lorenzogalli-dev/Prostart/Papers/Final Paper/CM2024_Sprint_Start_Final_Paper.pdf

## Prostart: Democratizing Sprint Training with a Low-Cost Reaction-Time and Photo-Finish System for Track & Field

Arianna Bartocci, Duarte Chambel, Lorenzo Galli, Loke Enlund Östangård, Ninad Purekar
KTH Royal Institute of Technology

Technology and Health Project Course - HT26

Abstract
Sprint races are decided by milliseconds, yet the systems that time reaction and finish are costly [1] and stay with federations and large clubs, while everyone else times by hand. We present Prostart: a start unit that mounts onto a standard starting block, and a phone app that turns a smartphone into a photo finish. The unit, an ESP32-C3 with a BMI270 accelerometer sampled at 804 Hz on a custom PCB in a 3D-printed box, gives the start commands, finds the push-off with a threshold-independent twostage onset picker, and sends the “go” instant over Bluetooth Low Energy (BLE) to the phone, which times the chest crossing the line with an on-device pose model, a synchronized clock and sub-frame interpolation. Against 240 fps video with an LED marking “go”, reaction times agreed within about 8 ms, the uncertainty of the video reference itself; finish times agreed with a 60 fps reference within 10 ms, a third of our one-frame target (33 ms at 30 fps), whereas hand timing read about 0.24 s fast.

### 1 Introduction

In competitive sprinting, athletes train for years to
gain a few hundredths of a second: Noah Lyles won
the Paris 2024 Olympic 100 m final by five thousandths [2]. Reaction times differ by several hundredths between elite sprinters [3], so part of the winning margin is decided before the athlete has even moved. Reaction time runs from the starting signal to the first force on the block; under 0.100 s is a false start, a limit based on the minimum auditory reaction time [4], and the fastest valid Olympic reactions lie just above it [3, 5]. The systems that measure it are installed at certified meets [6], and even a single-block training version lists at about US$1,600 [1]. Coaches therefore time by hand, which reads about 0.24 s faster than electronic timing [7]: an error larger than the gains an athlete trains for. Photocells start when the torso breaks a beam, so their times exclude the reaction [8]. FinishLynx ReacTime measures reaction to 1/1000 s from a sensor on every block [6]; its patent detects the onset when acceleration crosses a threshold [9], which by construction reports it late. Omega samples the force on the footrest at 4 kHz and pairs it with a finish camera of up to 40,000 images per second [10], and earlier student work used load cells, robust in 18 of 20 starts but without a timing-accuracy characterization [11]. All of these are either costly or built into the block, leaving a gap for a low-cost, portable system with a documented error budget.
This paper contributes (i) a start unit on one microcontroller, from schematic to PCB to printed enclosure, whose onset picker is independent of its threshold; (ii) a Flutter app that mirrors the start and turns the phone camera into a photo finish, synchronized to the unit over BLE; and (iii) a validation of both against high-speed video, with every error term named. The unit started as a breadboard prototype (Appendix B) and is now a complete system: the unit in its printed box and the app (Figure 1).


Figure 1. The complete system: the start unit in its printed box on the block (left) and the app (right).

### 2 System design

Architecture. The system has two devices joined by one radio link (Figure 2). The start unit sounds the commands, stamps them and the push-off on its own clock, and decides the verdict. The phone, standing at the finish, mirrors the start and times the finish. The microcontroller at the start reads the accelerometer and runs the radio. Each reading is timestamped in an interrupt and buffered in the sensor’s FIFO, so Bluetooth traffic can delay it but never silently shift or lose a reading. A direct BLE link covers about 30 m, enough for start and acceleration work; for a full 100 m we plan a second ESP32-C3 at the finish, linked to the start unit over long-range ESP-NOW, which we field-tested beyond 100 m, and to the phone over BLE.

BMI270
804 Hz, ±16 g

ESP32-C3
ISR stamps 1 µs

piezo
4 kHz

TFT +
button

FIFO

start unit (on the block)

camera
240 fps, 1/1000 s

MediaPipe Pose
chest front

crossing, interp.
tfin − tgo

phone app (at the finish)

events
marks, set, go,
result

BLE ping/pong
clock sync
Figure 2. System overview. The start unit judges the start; the phone gets the “go” on its clock and times the finish.

Prostart: Democratizing Sprint Training with a Low-Cost Reaction-Time and Photo-Finish System for Track & Field | 2

Hardware. A two-layer PCB (65.5×34 mm, Appendix B) carries an ESP32-C3 SuperMini, a BMI270
accelerometer breakout on I²C at 400 kHz with its data-ready line on an interrupt pin, a 1.77” display on SPI, a push button, and a 12 mm passive piezo. The unit runs from a USB power bank through the SuperMini’s USB-C port. The enclosure, 75×99.5×25 mm, was designed around the board and printed in three parts (Figure 3, left): a box with standoffs for the PCB, a lid with cutouts for the display and for the buzzer, and a button cap. Lastly a standard strap holds the box to the block’s rail. Figure 3 (right) shows the assembled board mounted on the standoffs inside the printed box.

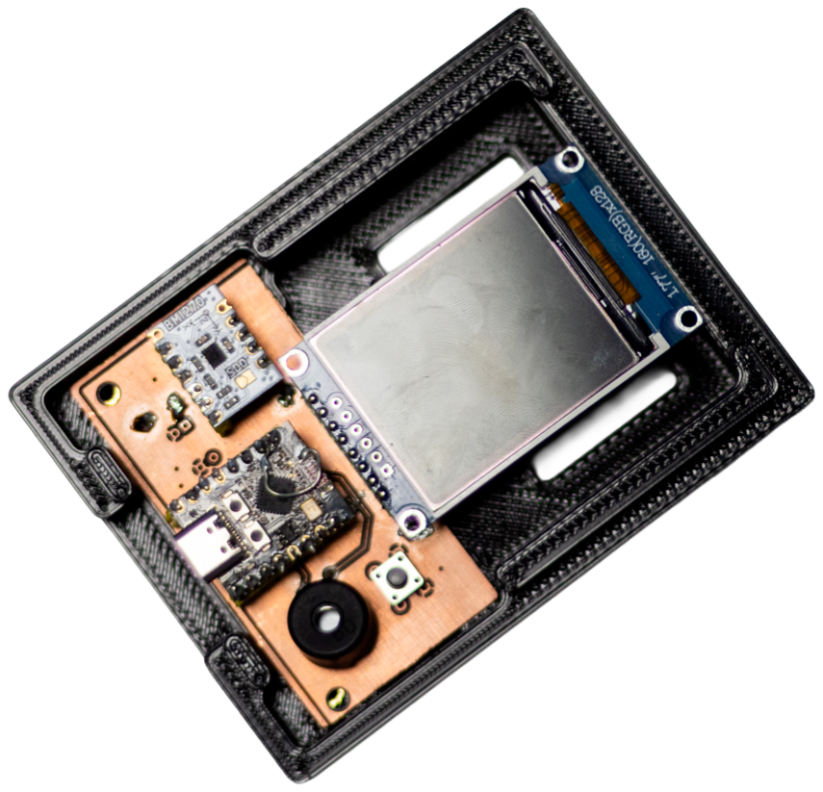
[picture p15: figure]

Figure 3. The enclosure: exploded render of the three printed parts from their STL files (left) and the assembled PCB inside the printed box (right).

Start sequence. A press starts a 3 s countdown, then “on your marks”; “set” follows 20–25 s later. The unit then waits until the sprinter is measured still (horizontal acceleration under 15 mg for 200 ms) and fires “go” a random 0.7–1.5 s later, which makes “go” hard to anticipate. Each beep is a 4 kHz, 100 ms tone and introduces no software latency into the reaction time.
Onset detection. The BMI270 runs at 800 Hz nominal (803.6 Hz measured), ±16 g. Gravity is estimated at rest as a vector, so every sample splits into vertical and horizontal parts whatever the mounting angle. An STA/LTA trigger [12] (15/800 ms windows, ratio 6, 20 mg floor) decides that the athlete moved; Maeda’s AIC picker [13] then finds, from 150 ms before to 50 ms after the trigger, the sample that best splits a quiet segment from an active one, and reports it as the onset. Because this second step has no threshold, the onset does not move with the trigger level: across 79 starts and thresholds of 10–50 mg it stayed on the same sample in 70 starts and within one in 74, while a threshold-only detector drifted by a median 9.3 ms (Appendix D). After the result, the unit sends the run to the app over BLE, which saves it as CSV; the board keeps it in RAM until the app confirms.
App and clock synchronization. The Flutter app (iOS) connects to the unit’s GATT service. In Reaction mode it mirrors the unit’s phases and shows the reaction time. In Photofinish mode it also times the finish and reports total, reaction and run time (Figure 4); for this, the board’s “go” instant must be converted to the phone’s clock, so the app estimates the offset θ (phone time minus board time). Between “on your marks” and “set” the phone pings the board for 10 s. Each ping has four timestamps: the phone sends at t1, the board receives at t2 and replies at t3, and the phone receives at t4. Each one-way difference equals ±θ plus a transmission delay that varies but is never negative, so the smallest value in each direction is the least noisy:
a = min(t2 − t1), | b = min(t4 − t3), | θ =
b−a
2
The two directions are minimized separately because BLE delays are asymmetric: a reply waits for the next connection event, which can skew a single round trip by up to one interval (15–30 ms on iOS) [14]. The offset error is bounded by half the minimum round trip, (a+b)/2, which the app computes on every sync. On an iPhone 13 this bound was 19 ms, set by the ∼30 ms iOS connection interval (forcing 15 ms had no effect). The bound is conservative, as it assumes the entire minimum delay falls in one direction; the end-to-end photofinish comparison (Sec. 3) suggests the actual error is considerably smaller. Clock drift (20–50 ppm) adds under 0.5 ms between sync and start.


Figure 4. The app’s result screen after a 10 m run on an iPhone 13.

Camera-based photo finish. The phone stands in line with the finish, and the user drags a line onto the real one. The camera runs at its highest frame rate (240 fps on an iPhone 13), with no stabilization and a short exposure (1/1000 s) against motion blur; every frame keeps the time it was captured, on the same clock the synchronization uses. From “go” the frames are kept in memory, and when a body enters a narrow band around the line, MediaPipe Pose [15] analyzes the pass. The rules time the torso [16], but the pose landmarks are joints inside the body, so the center of the torso crosses about 20 ms after the chest. We therefore take the chest front from the body silhouette: between shoulders and hips, with the arm removed, the frontmost edge of each row, and the 80th percentile of these edges, so a stray forearm cannot move it. Between the last frame before the line and the first after it, interpolation gives the crossing instant, and a line fit over ±160 ms

Prostart: Democratizing Sprint Training with a Low-Cost Reaction-Time and Photo-Finish System for Track & Field | 3

smooths per-frame noise. The time is shown to the
millisecond and, as the rules prescribe, rounded up
to the hundredth [16]. The detector was first written in Python and then ported to the app; on the same clips the two agree within a few ms (0.864 vs. 0.862 s at 240 fps).

### 3 Evaluation & Results

Timing path. On the PCB the unit samples at 803.6 Hz with no gaps and no dropped samples, a maximum interval of 1.25 ms, and 0.55 µs timestamp jitter. Re-running the detector offline on every capture gives the board’s onset on the same sample (e.g. 163.8 ms). The unit’s own resolution is therefore one sample, 1.2 ms. Figure 5 shows what the detector sees in a block start.


Figure 5. A block start recorded with the first prototype: raw acceleration, horizontal magnitude and STA/LTA ratio after “go” (green), with the AIC onset (black) at 138 ms, 16.2 ms before the threshold-only onset (dotted).

Reaction time vs. 240 fps video. As an independent reference, we filmed the block at 240 fps (4.2 ms per frame) during test starts and took the reaction time from the footage as the interval between the “go” signal and the push-off. The “go” instant is the first frame in which the green LED is lit. The push-off is harder to place: the shoe starts to compress against the block before the athlete visibly moves, so the frame was chosen by eye and may be off by a frame or two. Figure 6 shows the two video frames for an example start and the board’s reading.

Figure 6. Example start: the “go” frame with the green LED lit (left), the push-off frame at 240 fps (middle), and the reaction time shown by the prototype (right).
Board and video agreed within about 8 ms, roughly two frames. The buzzer was about 1.5 m from the athlete, so the sound arrives about 4.4 ms after “go” (at 343 m/s). This is a systematic offset, and for a known distance it can be subtracted. The board’s error is therefore at most about 8 ms, a bound set by the video reference itself; with a sharper reference, we expect it to approach the 1.24 ms sampling interval of the accelerometer. Photo finish. The finish time depends on the clock synchronization between the unit and the phone, the camera frame timestamps and the crossing detector, so we validated them together, end to end. In a test run against a 60 fps reference video read frame by frame, the app’s finish time differed by 10 ms. This is less than one frame of the reference video (16.7 ms) and well within the 33 ms (one frame at 30 fps) target set at the design stage. As with the reaction time, the reference cannot resolve differences much below one frame, while the app interpolates between the frames surrounding the line to obtain a sub-frame crossing time (Figure 7); more runs are needed to characterize its error. We also timed the same run by hand: the stopwatch read about 0.2– 0.3 s faster than the app, in line with the 0.24 s reported in the literature [7].


Figure 7. The app’s result frame at the crossing: finish line, body silhouette (cyan) and the timed chest point.

Limitations. The validation is preliminary: the finish time rests on a single run, and both video references bound the error rather than measure it; a finer validation is planned. Besides the constant delays, the direct BLE link reaches about 30 m, so a full 100 m needs the relay planned in Section 2. In low light the exposure cannot go below about 1/250 s, increasing motion blur. An arm across the chest can hide the chest edge, and with two athletes in frame the detector times the larger torso, so the app is meant for one athlete per run.

### 4 Conclusions

We built a start unit on one microcontroller, from PCB to printed box, and a phone app that together time a sprinter’s reaction and finish, for about 300 SEK in parts (Table 2), against about US$1,600 for a single-block commercial trainer [1]. Against video, reaction times agreed within about 8 ms, the uncertainty of the reference itself, and a first finish time within 10 ms, whereas a stopwatch read about 0.24 s fast. Next, a 1000 fps camera will check the unit’s 1.24 ms sampling interval directly and measure the constant delays of the sensor and the sound, and the unit, now powered by a USB power bank, will move to a built-in LiPo cell.

Prostart: Democratizing Sprint Training with a Low-Cost Reaction-Time and Photo-Finish System for Track & Field | 4

### References

[1] VS Athletics. ReacTime Personal Training System (SKU Z5110), Lynx. https://www.vsathletics.com/store/ReacTime-Personal-Training-System.html, (https://www.vsathletics.com/store/ReacTime-Personal-Training-System.html) accessed 21 Sept 2026.
[2] Olympics.com. Paris 2024 athletics: Noah Lyles wins Olympic men’s 100m gold in a photo finish, 2024. https: //www.olympics.com/en/news/noah-lyles-wins-paris-2024-athletics-olympic-mens-100m-gold, accessed 19 Sept 2026.
[3] D. B. Lipps, A. T. Galecki, and J. A. Ashton-Miller. On the implications of a sex difference in the reaction times of sprinters at the Beijing Olympics. PLoS ONE, 6(10):e26141, 2011. doi:10.1371/journal.pone.0026141.
[4] M. T. G. Pain and A. Hibbs. Sprint starts and the minimum auditory reaction time. Journal of Sports Sciences, 25(1):79–86, 2007. doi:10.1080/02640410600718004.
[5] K. C. Brosnan, K. Hayes, and A. J. Harrison. Effects of false-start disqualification rules on response-times of elitestandard sprinters. Journal of Sports Sciences, 35(10):929–935, 2017. doi:10.1080/02640414.2016.1201213.
[6] FinishLynx. | ReacTime false start detection system. | https://www.finishlynx.com/product/
reactime-false-start-detection/, (https://www.finishlynx.com/product/reactime-false-start-detection/) accessed 21 Sept 2026.
[7] J. B. Mann, P. J. Ivey, W. F. Brechue, and J. L. Mayhew. Validity and reliability of hand and electronic timing for 40-yd sprint in college football players. Journal of Strength and Conditioning Research, 29(6):1509–1514, 2015. doi:10.1519/JSC.0000000000000941.
[8] T. A. Haugen, E. Tønnessen, and S. K. Seiler. The difference is in the start: impact of timing and start procedure on sprint running performance. Journal of Strength and Conditioning Research, 26(2):473–479, 2012. doi:10.1519/JSC.0b013e318226030b.
[9] E. Widding, D. DeAngelis, and A. Barton (Lynx System Developers, Inc.). Reaction time measurement system. US Patent 6,002,336, 1999. PCT publication WO 1999/032889 A2.
[10] OMEGA. Official Timekeeper: a legacy of Olympic precision since 1932. https://www.omegawatches.com/en-us/world-of-omega/olympic-and-paralympic-games/official-timekeeper, (https://www.omegawatches.com/en-us/world-of-omega/olympic-and-paralympic-games/official-timekeeper) accessed 21 Sept 2026.
[11] F. Heim, I. R. Kristinsson, A. Rosato, and M. Zimmermann. Design of a sprint block for force and reaction time measurement. Course paper, November 2020.
[12] R. V. Allen. Automatic earthquake recognition and timing from single traces. Bulletin of the Seismological Society of America, 68(5):1521–1532, 1978.
[13] N. Maeda. A method for reading and checking phase times in auto-processing system of seismic wave data. Zisin (Journal of the Seismological Society of Japan), 38(3):365–379, 1985.
[14] F. Cristian. | Probabilistic clock synchronization. | Distributed Computing, 3(3):146–158, 1989.
doi:10.1007/BF01784024.
[15] V. Bazarevsky, I. Grishchenko, K. Raveendran, T. Zhu, F. Zhang, and M. Grundmann. BlazePose: on-device real-time body pose tracking. CVPR Workshop on Computer Vision for Augmented and Virtual Reality, 2020. arXiv:2006.10204.
[16] World Athletics. Competition Rules, Book C2.1: Technical Rules, Rule 19 (Timing and Photo Finish). https://worldathletics.org/about-iaaf/documents/book-of-rules, accessed 18 Oct 2026.
[17] Bosch Sensortec. BMI270: 6-axis smart, low-power inertial measurement unit, datasheet. https://www.bosch-sensortec.com/products/motion-sensors/imus/bmi270/, accessed 18 Oct 2026.

Prostart: Democratizing Sprint Training with a Low-Cost Reaction-Time and Photo-Finish System for Track & Field | 5

### A Source code

Everything needed to rebuild the system is in one repository, https://github.com/lorenzogalli-dev/Prostart:

Folder | Content
Arduino/AlgorithmRealTimeESP32/ | start-unit firmware (ESP32-C3 + BMI270, BLE); wiring, build and test notes
Arduino/AlgorithmRealTime/ | first prototype (XIAO nRF52840 Sense), same detector
Arduino/EspNowLrTest/ | long-range ESP-NOW field test for the finish relay, with its measurements
prostart/ | Flutter app and its native camera plugin (photo finish)
AI_Torso_Detector/ | Python reference of the photo-finish detector (MediaPipe)
Hardware/ | KiCad project, Gerbers and BOM (PCB_ProStart_POC/); enclosure STL files
(Enclosure/)
Data/, Arduino/*/Data/ | recorded block starts (CSV), used for the threshold sweep (Appendix D)
Table 1. Repository layout.

### B Hardware

The first prototype (Figure 8) was a Seeed XIAO nRF52840 Sense, whose on-board LSM6DS3 accelerometer sampled at about 865 Hz, with a button and the buzzer on a breadboard; it recorded the 79 block starts of Appendix D and validated the detector. The final unit moves to an ESP32-C3 with an external BMI270, whose FIFO decouples sampling from the radio, on a custom two-layer PCB (Figures 9 and 10). Table 2 lists the parts, the pin map and their cost.

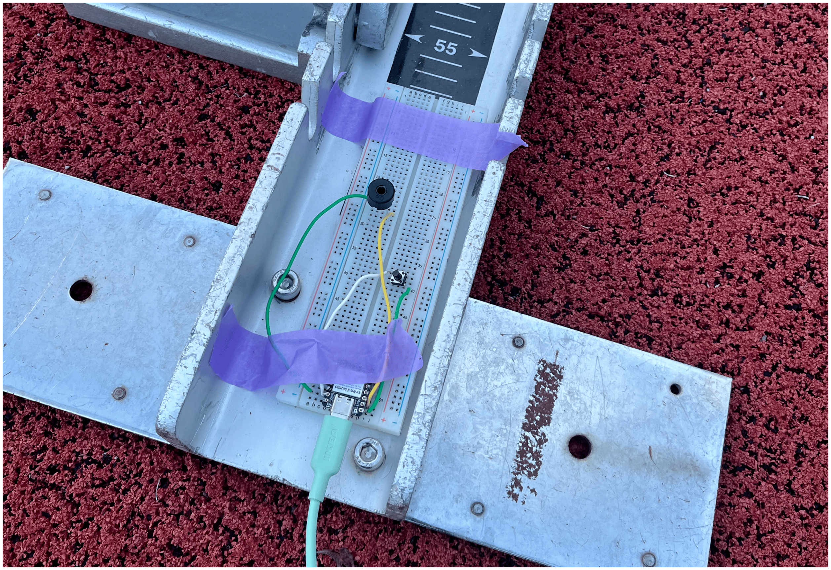
[picture p16: figure]
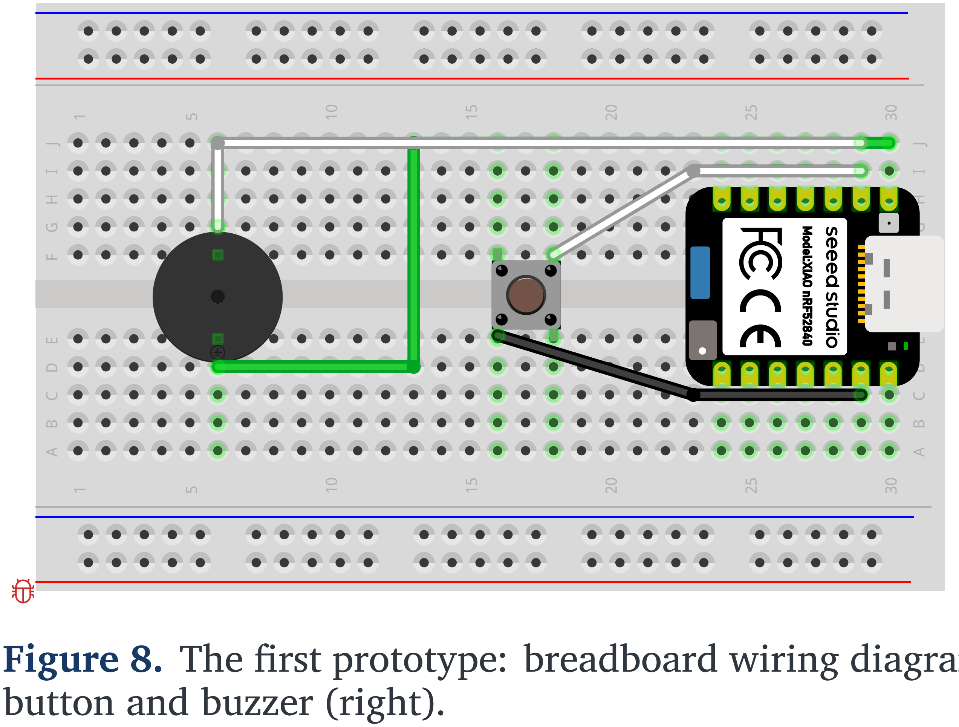
[picture p17: figure]
button and buzzer (right).

Figure 8. The first prototype: breadboard wiring diagram (left) and the real breadboard with the XIAO nRF52840 Sense,

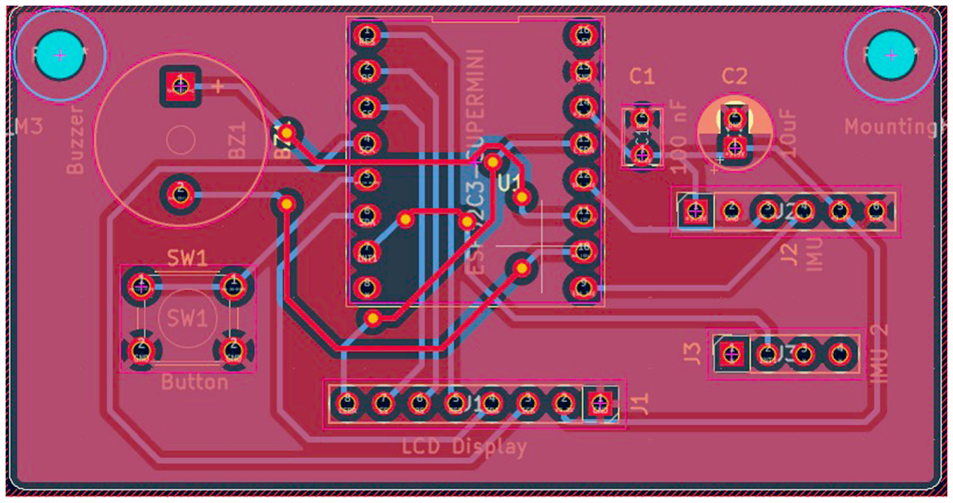
[picture p18: figure]

Figure 9. Schematic of the start unit (left) and routed layout of the 65.5×34 mm PCB (right). J2/J3: BMI270 breakout (I²C, INT1); J1: TFT display; BZ1: piezo between GPIO1 and GPIO2.

Prostart: Democratizing Sprint Training with a Low-Cost Reaction-Time and Photo-Finish System for Track & Field | 6

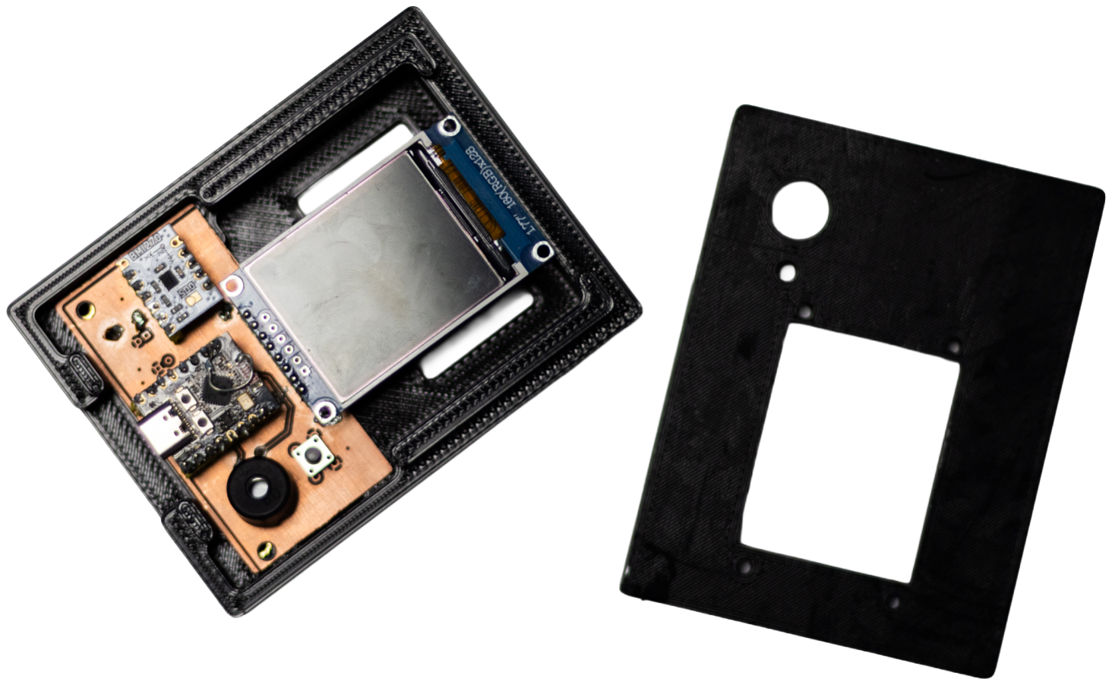
[picture p19: figure]
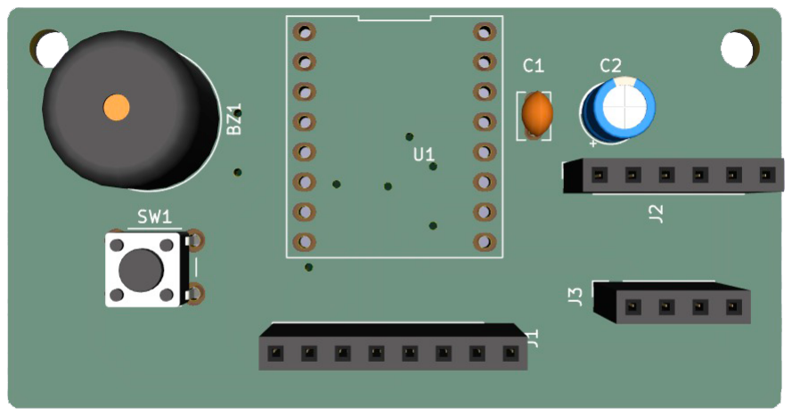
[picture p20: figure]

Figure 10. The final unit: 3D view of the PCB (left) and the assembled board with display in the printed box (right).

Ref. | Part | Connection | SEK*
U1 | ESP32-C3 SuperMini | – | 40
J2, J3 BMI270 breakout [17] | SDA GPIO0, SCL GPIO3, INT1 GPIO20 | 100
J1 | 1.77” ST7735 TFT, 128×160 | SCK 8, MOSI 10, CS 7, DC 6, RES 5, BL 4 | 70
SW1 | 6 mm push button | GPIO9 to GND | 5
BZ1 | 12 mm piezo buzzer | GPIO1 / GPIO2, antiphase | 10
C1, C2 100 nF, 10 µF | 3.3 V rail | 5
– | Two-layer PCB, 65.5×34 mm (batch of 5) – | 30
– | Printed box, lid and button cap (PLA) | – | 15
– | Strap | – | 20
| Total | | ≈295
Table 2. Bill of materials, pin map and estimated part prices. *Estimated one-off retail prices in October 2026, excluding the phone and the USB power bank that powers the unit. The green validation LED (GPIO21, Section 3) is not part of the product.

### C Firmware parameters and BLE protocol

Table 3 collects the constants of Section 2 in one place, while Table 4 is the GATT service the app talks to.

Parameter | Value
Sampling | BMI270, 800 Hz nominal (803.6 Hz measured), ±16 g, 0.488 mg/LSB; FIFO of 337 frames (0.42 s);
| data-ready stamped in the ISR (1 µs clock)
Sequence | countdown 3 s; marks → set 20–25 s; arm when <15 mg for 200 ms (at least 800 ms after set, at
| most 4 s); go 0.7–1.5 s after arming
Beep | 4 kHz, 100 ms, two register writes, stamped at the write
STA/LTA | 15 ms / 800 ms, on at ratio 6, off at 2, 20 mg floor, 15 ms confirmation
AIC window | 150 ms before, 50 ms after the trigger
False start | onset < 100 ms after go
Timing check before every verdict: no gap longer than 3 sample periods and no FIFO resynchronization since “set”, otherwise the start is reported as unusable Storage none on the board: the run waits in RAM until the app confirms it has saved it
Table 3. Start-unit parameters.

Characteristic Content
event (notify) type, counter (a gap reveals a lost event); countdown digit; marks/set/go board time (µs); result:
| verdict, reaction time, onset and go times
ping (write) | 16-bit sequence number from the phone
pong (notify) | sequence, board receive time, board send time; answered only before “set”
data (notify) | the last start’s recording: run info, samples (10 bytes each, up to 24 per packet on iOS), end of run
ctrl (write) | from the app: get a run or a range of samples; acknowledge a run once saved
Table 4. BLE GATT service of the start unit (UUIDs F7280000-… to F7280005-…). Board times are 32-bit microseconds, unwrapped by the app.

Prostart: Democratizing Sprint Training with a Low-Cost Reaction-Time and Photo-Finish System for Track & Field | 7

### D Threshold independence of the onset

A detector that reports the instant its signal crosses a threshold reports a later onset the higher the threshold, and on a slow push-off by several milliseconds. To check that the AIC picker does not, we re-ran the offline detector on all 79 block starts recorded with the first prototype, sweeping the detection threshold from 10 to 50 mg, once with the AIC picker and once without, and measured how far the reported onset moved from its value at the lowest threshold (Figure 11). The AIC onset stayed on the same sample in 70 starts and within one sample in 74, while the threshold-only onset drifted by a median 9.3 ms over the sweep. The detector’s threshold therefore decides only whether the athlete moved, not when.

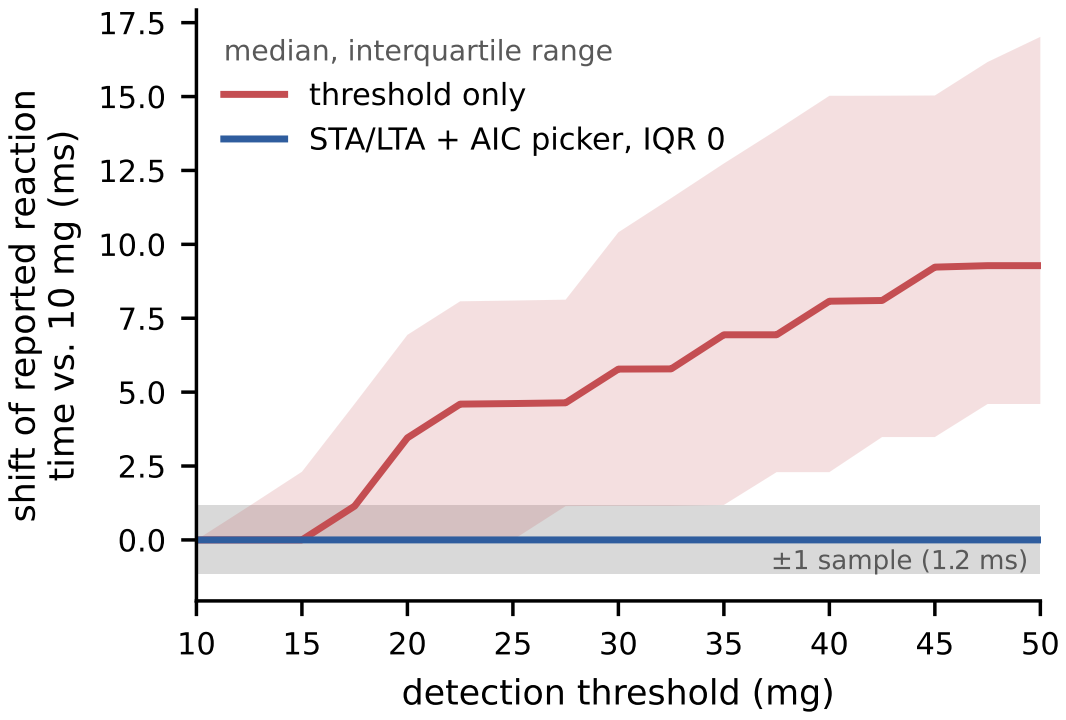
[picture p21: figure]
detection threshold (mg); shift of reported reaction; time vs. 10 mg (ms); ±1 sample (1.2 ms); median, interquartile range threshold only; STA/LTA + AIC picker, IQR 0

Figure 11. Threshold sweep over 79 block starts recorded with the first prototype (10–50 mg): the AIC onset stays fixed while threshold-only detection drifts (median 9.3 ms).
