lorenzogalli-dev/Prostart/prostart/packages/photofinish_camera/README.md

# photofinish_camera

A new Flutter plugin project.

## Getting Started

This project is a starting point for a Flutter
[plug-in package](https://flutter.dev/to/develop-plugins),
a specialized package that includes platform-specific implementation code for
Android and/or iOS.

For help getting started with Flutter development, view the
[online documentation](https://docs.flutter.dev), which offers tutorials,
samples, guidance on mobile development, and a full API reference.
