lorenzogalli-dev/Prostart/Papers/Final Paper/figures/fig_error_scale.pdf

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

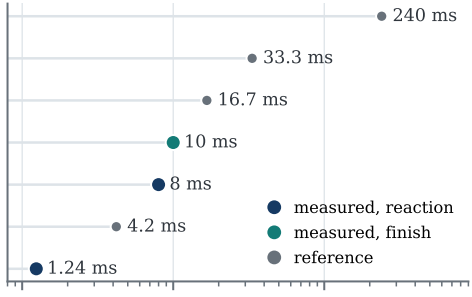
[picture p25: figure]
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
