lorenzogalli-dev/Prostart/Papers/Final Paper/figures/app.jpg

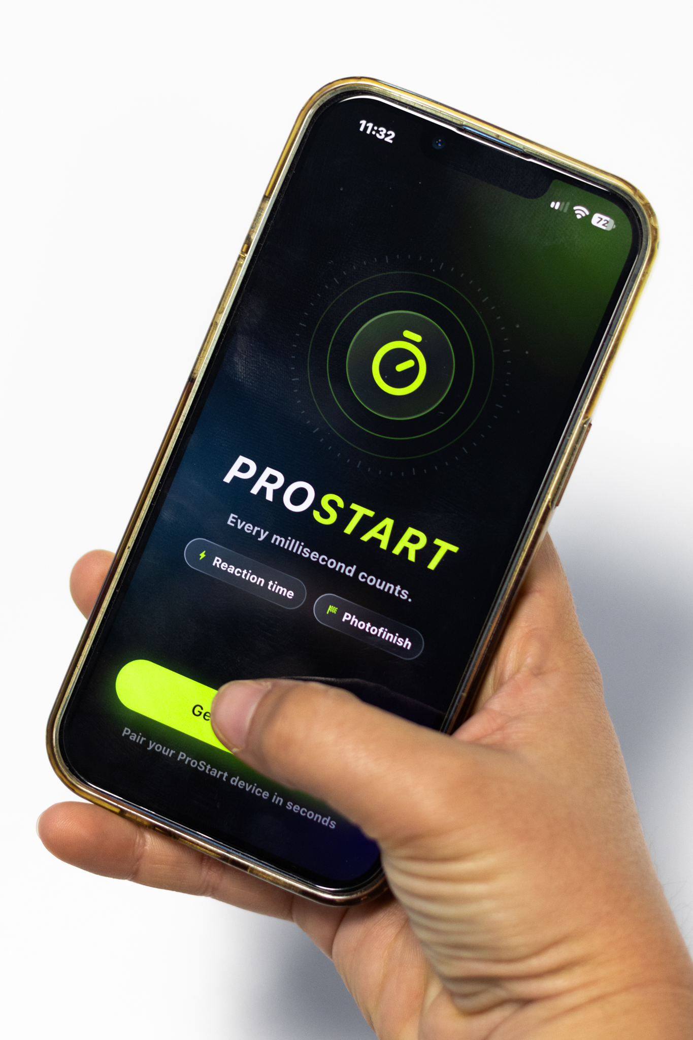
Papers/Final Paper/figures/app.jpg
