lorenzogalli-dev/Prostart/Papers/Final Paper/figures/fig-box.jpg

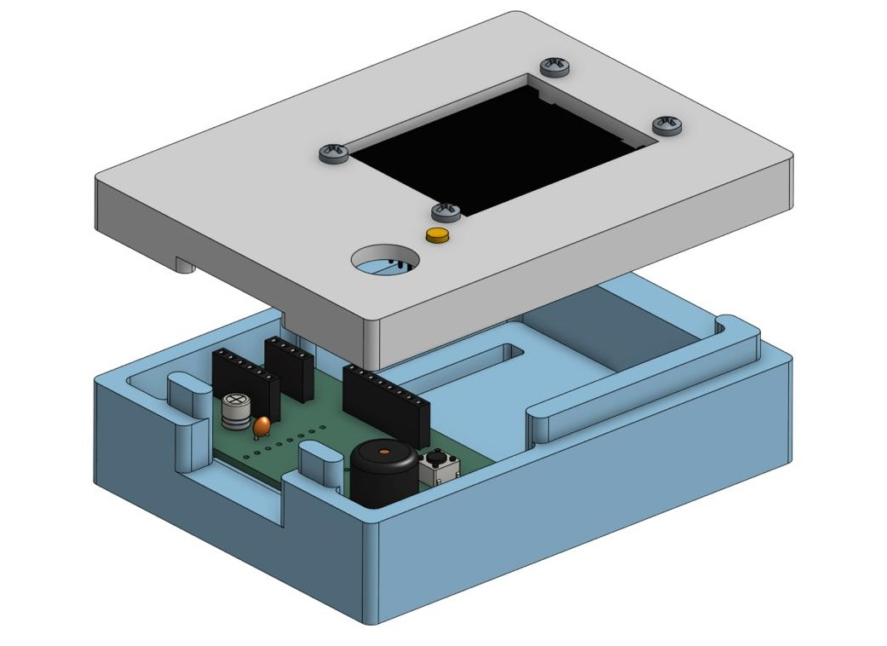
Papers/Final Paper/figures/fig-box.jpg
