lorenzogalli-dev/Prostart/Papers/Final Paper/figures/fig_box.png

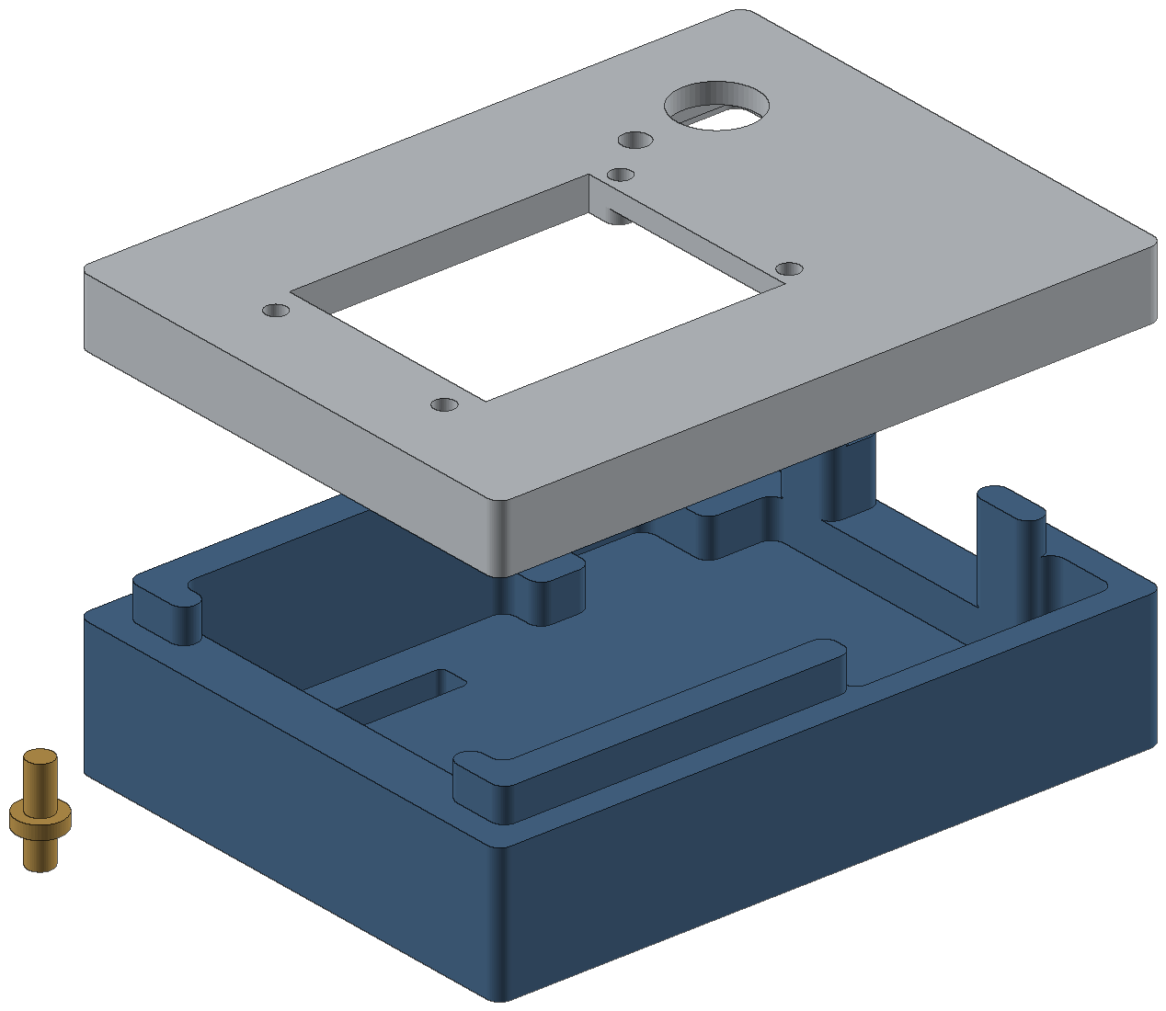
Papers/Final Paper/figures/fig_box.png
