lorenzogalli-dev/Prostart/Papers/Final Paper/figures/finished_unit.jpg

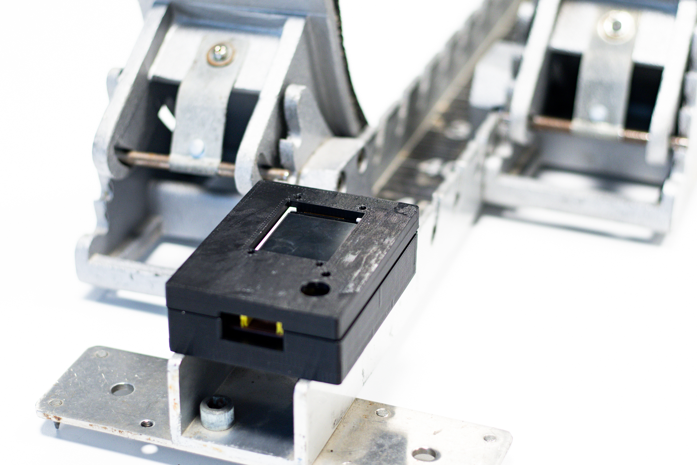
Papers/Final Paper/figures/finished_unit.jpg
