lorenzogalli-dev/Prostart/Papers/Final Paper/figures/photofinish.png

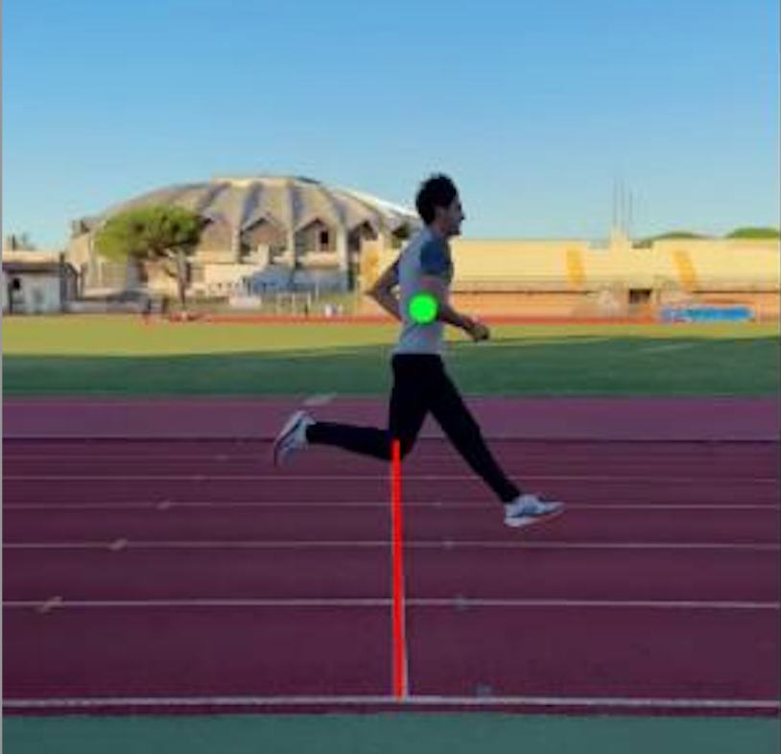
Papers/Final Paper/figures/photofinish.png
