lorenzogalli-dev/Prostart/Papers/Final Paper/figures/placeholder_app.png

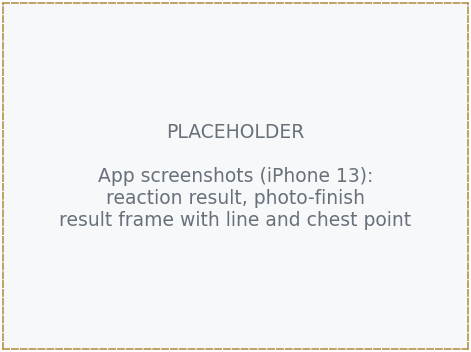
Papers/Final Paper/figures/placeholder_app.png
