lorenzogalli-dev/Prostart/Papers/Final Paper/figures/placeholder_finish_frame.png

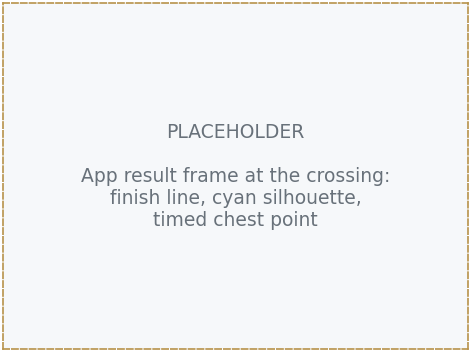
Papers/Final Paper/figures/placeholder_finish_frame.png
