lorenzogalli-dev/Prostart/Papers/Final Paper/figures/placeholder_finished_unit.png

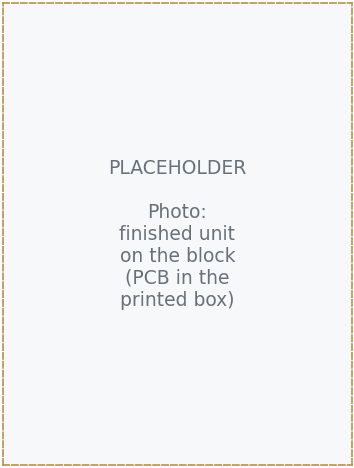
Papers/Final Paper/figures/placeholder_finished_unit.png
