lorenzogalli-dev/Prostart/Papers/Final Paper/figures/placeholder_pcb_photo.png

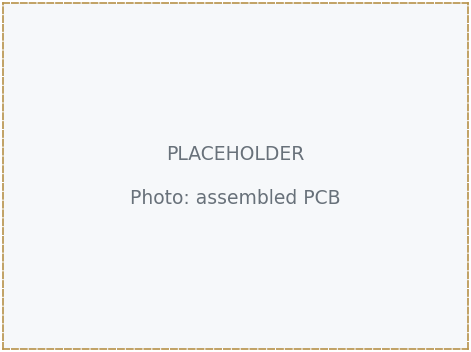
Papers/Final Paper/figures/placeholder_pcb_photo.png
