lorenzogalli-dev/Prostart/Hardware/Enclosure/start_box.stl

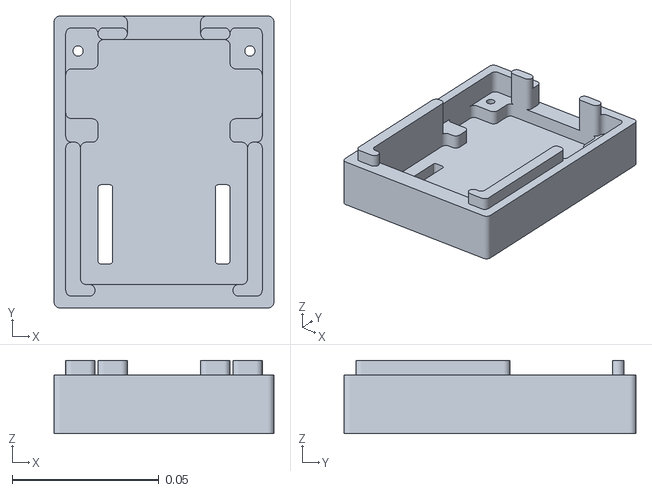
[picture p35: CAD file, 2026-10-18]
Hardware/Enclosure/start_box.stl
0.075 x 0.0995 x 0.025
