lorenzogalli-dev/Prostart/Hardware/PCB_ProStart_POC/PCB_step.step

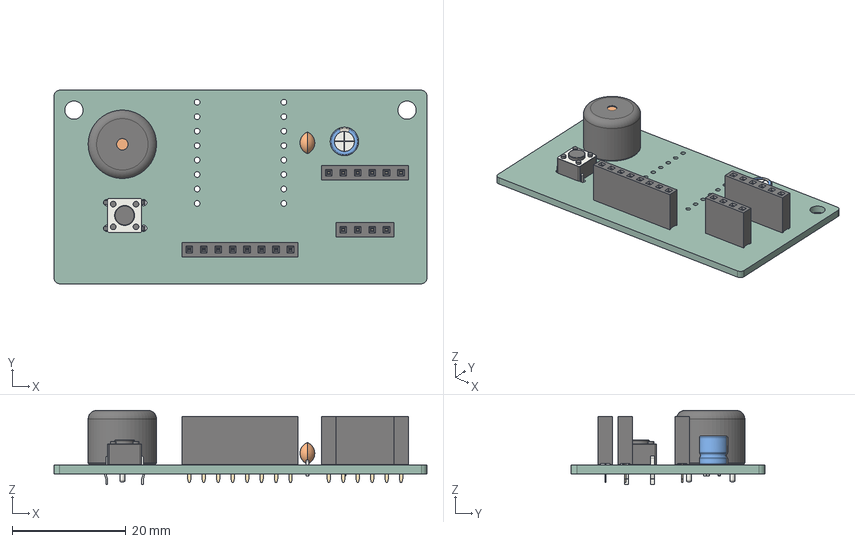
[picture p36: CAD file, 2026-10-18]
Hardware/PCB_ProStart_POC/PCB_step.step
65.5 x 34.0 x 13.0 mm
CP_Radial_D50mm_P200mm
PinSocket_1x08_P2.54mm_Vertical
PinSocket_1x06_P2.54mm_Vertical
PinSocket_1x04_P2.54mm_Vertical
Buzzer_12x95RM76
C_Disc_D38mm_W26mm_P250mm
SW_PUSH_6mm
PCB_ProStart_POC_PCB
