lorenzogalli-dev/Prostart/Hardware/Enclosure/start_box_lid.stl

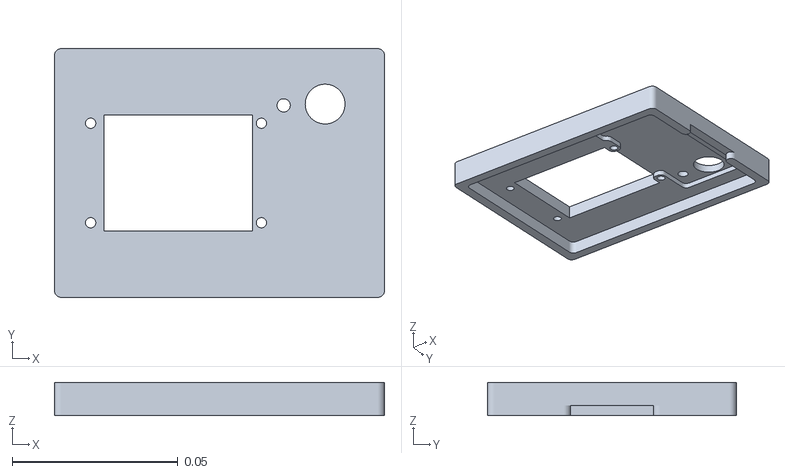
[picture p37: CAD file, 2026-10-18]
Hardware/Enclosure/start_box_lid.stl
0.0995 x 0.075 x 0.01
