lorenzogalli-dev/Prostart/Hardware/Enclosure/start_box_button.stl

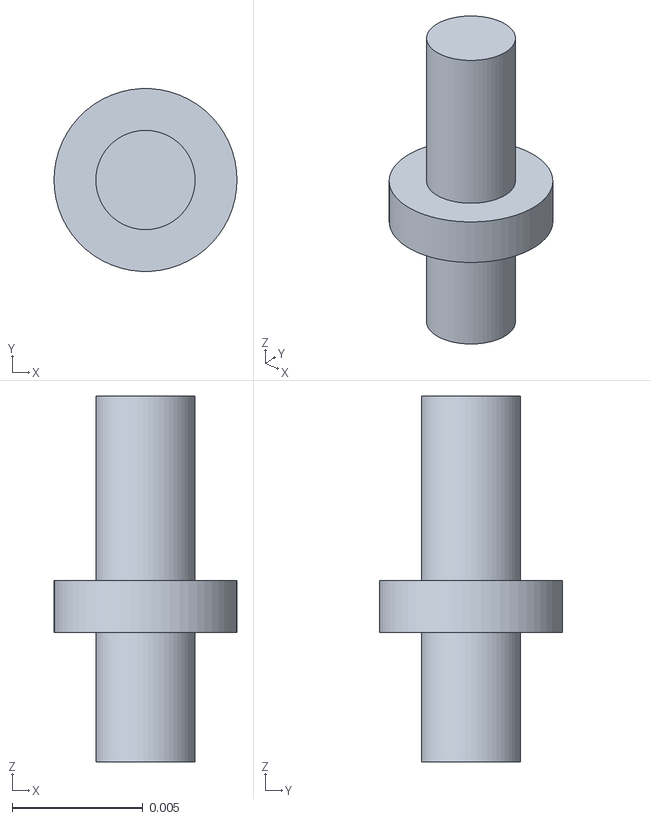
[picture p38: CAD file, 2026-10-18]
Hardware/Enclosure/start_box_button.stl
0.007 x 0.00699 x 0.014
