lorenzogalli-dev/Prostart/Papers/Final Paper/figures/placeholder_validation.png

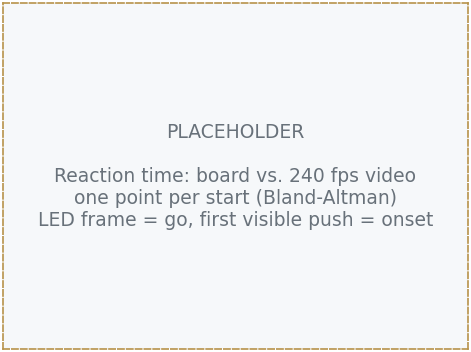
Papers/Final Paper/figures/placeholder_validation.png
