lorenzogalli-dev/Prostart/Papers/Final Paper/figures/prototype.pdf

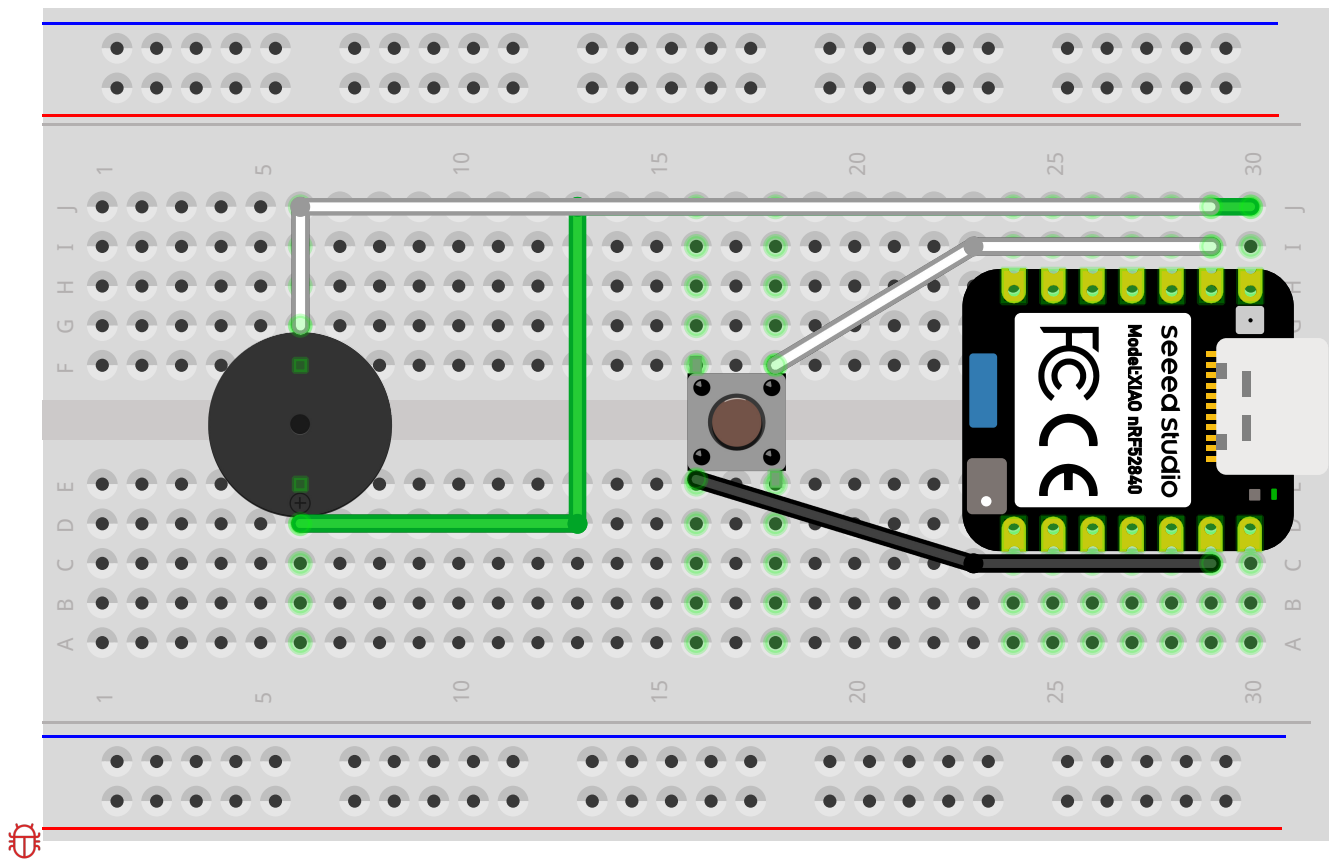
[picture p40: page 1]
