lorenzogalli-dev/Prostart/(list of files, drawings)

Other design files:
Hardware/PCB_ProStart_POC/freerouting.dsn
Hardware/PCB_ProStart_POC/PCB_ProStart_POC.dsn
