lorenzogalli-dev/Prostart/Hardware/PCB_ProStart_POC/PCB_ProStart_POC.kicad_pcb

## KiCad design Hardware/PCB_ProStart_POC/PCB_ProStart_POC.kicad_pcb (2026-10-18)

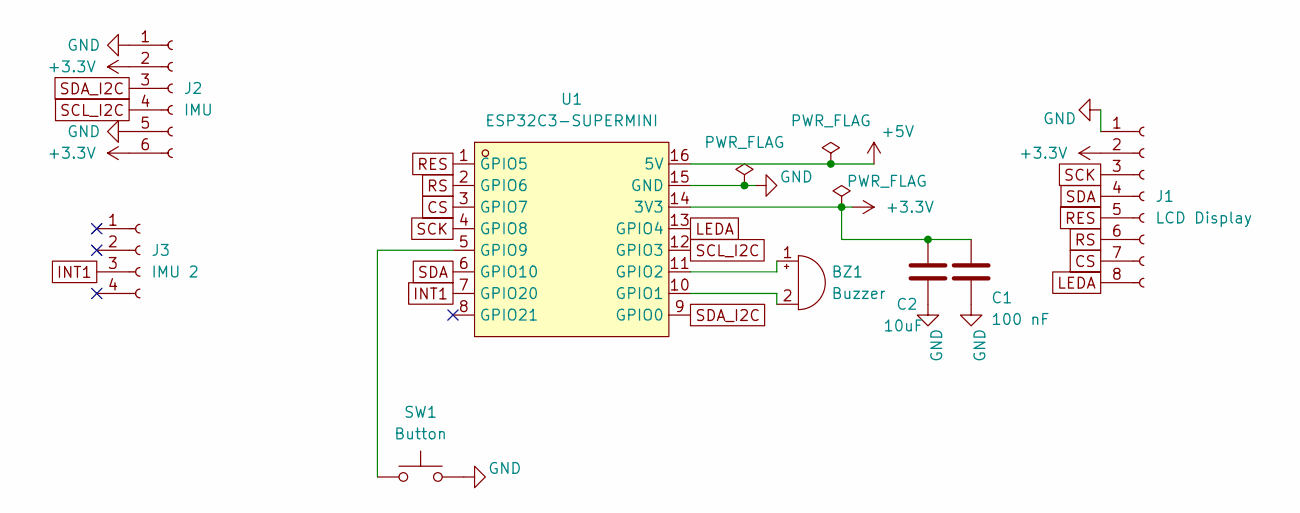
[picture p42: schematic PCB_ProStart_POC.kicad_sch]

Parts:
BZ1: Buzzer; Buzzer_12x9.5RM7.6
C1: 100 nF; C_Disc_D3.8mm_W2.6mm_P2.50mm
C2: 10uF; CP_Radial_D5.0mm_P2.00mm
J1: LCD Display; PinSocket_1x08_P2.54mm_Vertical
J2: IMU; PinSocket_1x06_P2.54mm_Vertical
J3: IMU 2; PinSocket_1x04_P2.54mm_Vertical
SW1: Button; SW_PUSH_6mm
U1: ESP32C3-SUPERMINI; DIP-ESP; MPN ESP32C3-SuperMini; LCSC Part C9900147397

Connections:
+3.3V: C1.1, C2.1, J1.2, J2.2, J2.6, U1.14 (3V3)
+5V: U1.16 (5V)
CS: J1.7, U1.3 (GPIO7)
GND: C1.2, C2.2, J1.1, J2.1, J2.5, SW1.2, U1.15 (GND)
INT1: J3.3 (Pin_3_3), U1.7 (GPIO20)
LEDA: J1.8, U1.13 (GPIO4)
unnamed: BZ1.1 (+), U1.11 (GPIO2)
unnamed: BZ1.2 (-), U1.10 (GPIO1)
unnamed: SW1.1, U1.5 (GPIO9)
RES: J1.5, U1.1 (GPIO5)
RS: J1.6, U1.2 (GPIO6)
SCK: J1.3, U1.4 (GPIO8)
SCL_I2C: J2.4, U1.12 (GPIO3)
SDA: J1.4, U1.6 (GPIO10)
SDA_I2C: J2.3, U1.9 (GPIO0)

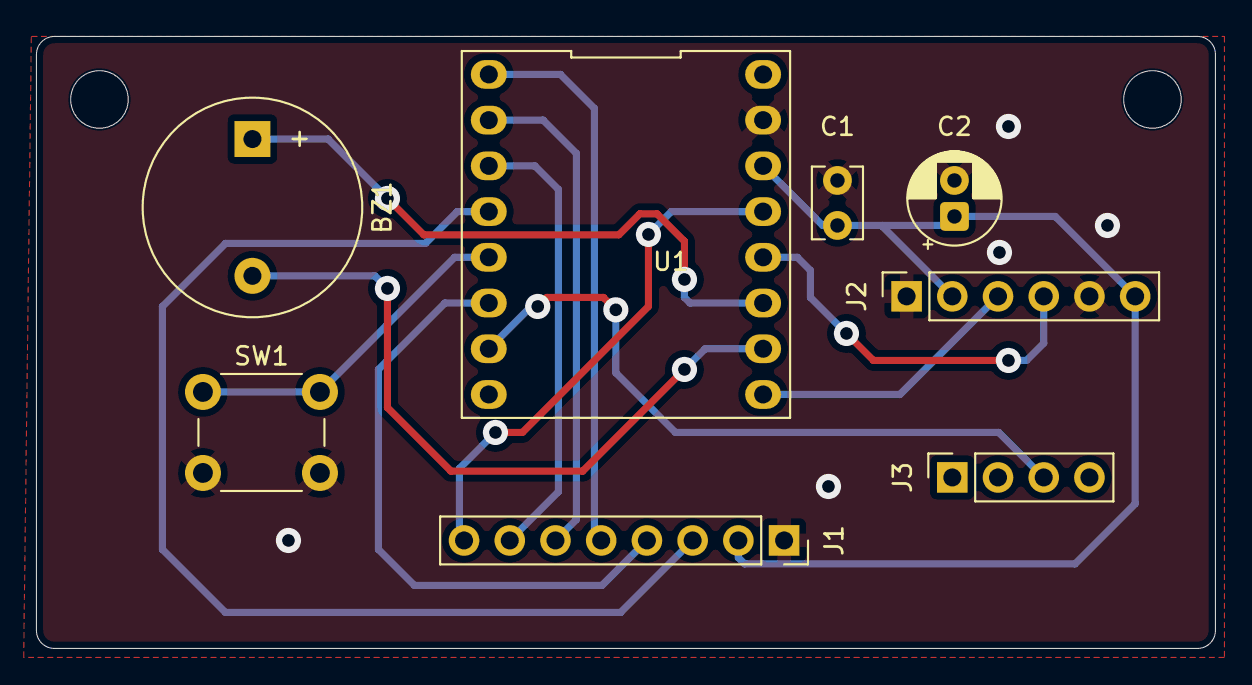
[picture p43: board PCB_ProStart_POC.kicad_pcb from above]

Board: 2 copper layers, 65.5 x 34.0 mm, 8 parts (0 on the bottom side), 14 nets.
