lorenzogalli-dev/Prostart/Arduino/AlgorithmRealTimeESP32/Bmi270.h

#pragma once
// ---------------------------------------------------------------------------
// Bmi270.h - accelerometer-only BMI270 driver over I2C, register level.
//
// Own driver rather than a library for the same reason Display.h is one: the
// read on the sample path has to be ONE burst transaction and nothing else,
// and every register the measurement depends on (ODR, filter, range, the
// data-ready routing) is set here in plain sight instead of inside a library
// default. Register map and the init procedure follow Bosch's BMI270_SensorAPI
// v2.86.1 (bmi2.c, bmi2_defs.h); the config blob is Bmi270Config.h.
//
// Configuration, and why:
//   ODR 800 Hz       BMI270 rates are 25 x 2^n: 800 is the step nearest the
//                    833 Hz the XIAO ran. 1600 would need a smaller display
//                    budget and a larger MAX_AIC; not worth it untested.
//   filter_perf = 1  performance mode: the full-rate digital filter, not the
//                    duty-cycled low-power path (which adds jitter).
//   bwp = normal     Bosch's default (0xA8 = perf | normal | 100 Hz). Its
//                    group delay is a FIXED offset on every onset, and it is
//                    not the LSM6DS3's: see INFO.md, it has to be measured.
//   +/-16 g          2048 LSB/g = 0.488 mg/LSB, the same resolution the
//                    LSM6DS3 had at 16 g, so the thresholds keep their units.
//   INT1 = data-ready, push-pull, active high, non-latched. Used ONLY as a
//                    clock: the ISR stamps each edge, nothing reads on it.
//   FIFO             accel only, headerless (6 bytes/frame), filtered data
//                    (the same filter path as the data registers, so the
//                    group delay does not change), overwrite when full.
//                    MEASURED 16/10: it saturates at 337 frames (~2 KB),
//                    0.42 s at 800 Hz - not the 1024 frames / 1.28 s this
//                    file assumed until then. Every sample goes through it,
//                    so a loop that stalls for less than that loses nothing;
//                    a longer stall overwrites the oldest frames, which
//                    pullFifo() detects (stamps outnumber frames) and resyncs.
// ---------------------------------------------------------------------------
#include <Wire.h>
#include "Pins.h"
#include "Bmi270Config.h"

static const uint8_t BMI270_ADDR = 0x68;   // SDO to GND; 0x69 with SDO high

enum : uint8_t {
  BMI_CHIP_ID         = 0x00,   // reads 0x24
  BMI_ERR_REG         = 0x02,
  BMI_STATUS          = 0x03,
  BMI_ACC_X_LSB       = 0x0C,   // X/Y/Z, 6 bytes, little endian
  BMI_INT_STATUS_1    = 0x1D,
  BMI_INTERNAL_STATUS = 0x21,   // low nibble 0x1 = config loaded, running
  BMI_FIFO_LENGTH_0   = 0x24,   // byte count, 14 bits over 0x24/0x25
  BMI_FIFO_DATA       = 0x26,
  BMI_ACC_CONF        = 0x40,
  BMI_ACC_RANGE       = 0x41,
  BMI_FIFO_DOWNS      = 0x45,
  BMI_FIFO_CONFIG_0   = 0x48,
  BMI_FIFO_CONFIG_1   = 0x49,
  BMI_INT1_IO_CTRL    = 0x53,
  BMI_INT_LATCH       = 0x55,
  BMI_INT_MAP_DATA    = 0x58,
  BMI_INIT_CTRL       = 0x59,
  BMI_INIT_ADDR_0     = 0x5B,
  BMI_INIT_DATA       = 0x5E,
  BMI_PWR_CONF        = 0x7C,
  BMI_PWR_CTRL        = 0x7D,
  BMI_CMD             = 0x7E,
};

static const uint8_t BMI_CHIP_ID_VALUE = 0x24;
static const uint8_t BMI_ACC_ODR_800   = 0x0B;
static const uint8_t BMI_ACC_BWP_NORM  = 0x02;   // normal_avg4
static const uint8_t BMI_ACC_PERF      = 0x80;
static const uint8_t BMI_ACC_RANGE_16G = 0x03;

static const uint8_t BMI_ACC_CONF_VALUE = BMI_ACC_PERF | (BMI_ACC_BWP_NORM << 4) | BMI_ACC_ODR_800;

static const uint8_t  BMI_FIFO_DOWNS_VALUE = 0x80;   // acc_fifo_filt_data, no downsampling
static const uint8_t  BMI_FIFO_CONF0_VALUE = 0x00;   // overwrite oldest when full, no sensortime
static const uint8_t  BMI_FIFO_CONF1_VALUE = 0x40;   // acc_en, header off
static const uint16_t BMI_FIFO_FRAME_BYTES = 6;
static const uint16_t BMI_FIFO_MAX_FRAMES  = 337;    // measured saturation, not the datasheet's
// Frames per FIFO_DATA read: Wire's buffer on this core is 128 bytes.
static const uint16_t BMI_FIFO_READ_FRAMES = 20;

// Why the last bmiBegin() failed, for the serial banner.
static const char* bmiError = "";
static uint8_t bmiErrorValue = 0;

static bool bmiWrite(uint8_t reg, uint8_t v) {
  Wire.beginTransmission(BMI270_ADDR);
  Wire.write(reg);
  Wire.write(v);
  return Wire.endTransmission() == 0;
}

static bool bmiWriteBurst(uint8_t reg, const uint8_t* d, size_t n) {
  Wire.beginTransmission(BMI270_ADDR);
  Wire.write(reg);
  Wire.write(d, n);
  return Wire.endTransmission() == 0;
}

static bool bmiRead(uint8_t reg, uint8_t* buf, size_t n) {
  Wire.beginTransmission(BMI270_ADDR);
  Wire.write(reg);
  if (Wire.endTransmission(false) != 0) return false;
  if (Wire.requestFrom(BMI270_ADDR, (uint8_t)n) != n) return false;
  for (size_t i = 0; i < n; i++) buf[i] = Wire.read();
  return true;
}

static uint8_t bmiRead8(uint8_t reg) {
  uint8_t v = 0xFF;
  bmiRead(reg, &v, 1);
  return v;
}

static bool bmiFail(const char* why, uint8_t value) {
  bmiError = why;
  bmiErrorValue = value;
  return false;
}

// A reset of the C3 in the middle of a read can leave the BMI270 holding SDA
// low, and then nothing on the bus answers until power is cycled. Nine clocks
// let it finish the byte it was sending and release the line.
// Not run before the first init: the colleague's board only came up on 07/10
// with it left out (together with the two longer delays in bmiBegin), and
// which of the three it was is not known yet. setup() runs it only after a
// failed init, before the one retry (16/10: an upload left the IMU dead).
static void i2cBusRecover() {
  pinMode(IMU_SDA_PIN, INPUT_PULLUP);
  pinMode(IMU_SCL_PIN, INPUT_PULLUP);
  delayMicroseconds(10);
  if (digitalRead(IMU_SDA_PIN) == HIGH) return;
  pinMode(IMU_SCL_PIN, OUTPUT);
  for (int i = 0; i < 9 && digitalRead(IMU_SDA_PIN) == LOW; i++) {
    digitalWrite(IMU_SCL_PIN, LOW);  delayMicroseconds(5);
    digitalWrite(IMU_SCL_PIN, HIGH); delayMicroseconds(5);
  }
  pinMode(IMU_SCL_PIN, INPUT_PULLUP);
}

// Init-time only: one line per step on serial, so a board that does not come
// up says where it stopped. Never used on the sample path.
static void bmiLog(const char* step, uint8_t value) {
  Serial.printf("BMI270,%s,0x%02X\n", step, value);
}

// Writes one register and fails bmiBegin() with the step name if the bus
// does not ACK.
static bool bmiInitWrite(const char* step, uint8_t reg, uint8_t v) {
  if (bmiWrite(reg, v)) return true;
  bmiLog(step, v);
  return bmiFail(step, v);
}

// Full power-up: soft reset, config upload, accelerometer only. ~200 ms.
// Delays and per-write checks as in the colleague's version that worked on
// the PCB on 07/10 (10 ms after Wire.begin, 5 ms after the soft reset).
static bool bmiBegin() {
  // The internal pull-ups (~45 kOhm) are what Wire enables; at 400 kHz they
  // are only enough if the breakout carries its own (the PCB has none).
  Wire.begin(IMU_SDA_PIN, IMU_SCL_PIN, 400000);
  delay(10);

  uint8_t id = bmiRead8(BMI_CHIP_ID);
  bmiLog("chip_id", id);
  if (id != BMI_CHIP_ID_VALUE) return bmiFail("chip id (wiring, 0x68/0x69, CS high?)", id);

  if (!bmiInitWrite("soft reset", BMI_CMD, 0xB6)) return false;
  delay(5);

  // Config upload, Bosch's sequence: advanced power save off (it otherwise
  // needs 450 us between writes), INIT_CTRL 0, blob in bursts at INIT_ADDR
  // (counted in 16-bit words), INIT_CTRL 1, then wait for the chip to report
  // it is running it.
  if (!bmiInitWrite("PWR_CONF write", BMI_PWR_CONF, 0x00)) return false;
  delayMicroseconds(450);
  if (!bmiInitWrite("INIT_CTRL 0", BMI_INIT_CTRL, 0x00)) return false;
  // 32 data bytes per burst: Wire's buffer on this core is 128, and the
  // register byte has to fit in the same transmission.
  const uint16_t CHUNK = 32;
  for (uint16_t i = 0; i < BMI270_CONFIG_SIZE; i += CHUNK) {
    uint8_t addr[2] = {(uint8_t)((i / 2) & 0x0F), (uint8_t)((i / 2) >> 4)};
    if (!bmiWriteBurst(BMI_INIT_ADDR_0, addr, 2) ||
        !bmiWriteBurst(BMI_INIT_DATA, &bmi270_config_file[i], CHUNK)) {
      bmiLog("config upload", (uint8_t)(i >> 8));
      return bmiFail("config upload", (uint8_t)(i >> 8));
    }
  }
  if (!bmiInitWrite("INIT_CTRL 1", BMI_INIT_CTRL, 0x01)) return false;

  uint8_t st = 0;
  uint32_t t0 = millis();
  while (millis() - t0 < 200) {
    delay(5);
    st = bmiRead8(BMI_INTERNAL_STATUS) & 0x0F;
    if (st == 0x01) break;
  }
  bmiLog("internal_status", st);
  if (st != 0x01) return bmiFail("INTERNAL_STATUS (config not accepted)", st);

  // Accelerometer only, performance mode.
  if (!bmiInitWrite("PWR_CTRL", BMI_PWR_CTRL, 0x04) ||                 // acc_en
      !bmiInitWrite("ACC_CONF", BMI_ACC_CONF, BMI_ACC_CONF_VALUE) ||
      !bmiInitWrite("ACC_RANGE", BMI_ACC_RANGE, BMI_ACC_RANGE_16G) ||
      !bmiInitWrite("INT1_IO_CTRL", BMI_INT1_IO_CTRL, 0x0A) ||        // output_en | active high, push-pull
      !bmiInitWrite("INT_LATCH", BMI_INT_LATCH, 0x00) ||              // non-latched
      !bmiInitWrite("INT_MAP_DATA", BMI_INT_MAP_DATA, 0x04) ||        // drdy -> INT1
      !bmiInitWrite("FIFO_DOWNS", BMI_FIFO_DOWNS, BMI_FIFO_DOWNS_VALUE) ||
      !bmiInitWrite("FIFO_CONFIG_0", BMI_FIFO_CONFIG_0, BMI_FIFO_CONF0_VALUE) ||
      !bmiInitWrite("FIFO_CONFIG_1", BMI_FIFO_CONFIG_1, BMI_FIFO_CONF1_VALUE) ||
      !bmiInitWrite("PWR_CONF final", BMI_PWR_CONF, 0x02)) {          // adv_power_save off, fifo_self_wakeup on
    return false;
  }
  delay(2);

  // Read back what the measurement depends on: a register the chip refused
  // (an invalid ODR/bandwidth combination is silently replaced) must not pass.
  uint8_t conf = bmiRead8(BMI_ACC_CONF);
  bmiLog("acc_conf", conf);
  if (conf != BMI_ACC_CONF_VALUE) return bmiFail("ACC_CONF read back", conf);
  uint8_t range = bmiRead8(BMI_ACC_RANGE);
  bmiLog("acc_range", range);
  if (range != BMI_ACC_RANGE_16G) return bmiFail("ACC_RANGE read back", range);
  uint8_t fifo1 = bmiRead8(BMI_FIFO_CONFIG_1);
  bmiLog("fifo_config_1", fifo1);
  if (fifo1 != BMI_FIFO_CONF1_VALUE) return bmiFail("FIFO_CONFIG_1 read back", fifo1);
  uint8_t downs = bmiRead8(BMI_FIFO_DOWNS);
  bmiLog("fifo_downs", downs);
  if (downs != BMI_FIFO_DOWNS_VALUE) return bmiFail("FIFO_DOWNS read back", downs);
  uint8_t err = bmiRead8(BMI_ERR_REG);
  bmiLog("err_reg", err);
  if (err != 0) return bmiFail("ERR_REG", err);
  return true;
}

// The one read on the sample path: X/Y/Z in a single burst.
static void bmiReadAccelRaw(int16_t* x, int16_t* y, int16_t* z) {
  uint8_t b[6] = {0, 0, 0, 0, 0, 0};
  bmiRead(BMI_ACC_X_LSB, b, 6);
  *x = (int16_t)((uint16_t)b[0] | ((uint16_t)b[1] << 8));
  *y = (int16_t)((uint16_t)b[2] | ((uint16_t)b[3] << 8));
  *z = (int16_t)((uint16_t)b[4] | ((uint16_t)b[5] << 8));
}

// Whole frames waiting in the FIFO, or -1 if the bus did not answer.
static int32_t bmiFifoFrames() {
  uint8_t b[2];
  if (!bmiRead(BMI_FIFO_LENGTH_0, b, 2)) return -1;
  uint16_t bytes = (uint16_t)b[0] | ((uint16_t)(b[1] & 0x3F) << 8);
  return bytes / BMI_FIFO_FRAME_BYTES;
}

// Pops n (<= BMI_FIFO_READ_FRAMES) frames, oldest first, into x/y/z.
static bool bmiFifoRead(uint16_t n, int16_t* x, int16_t* y, int16_t* z) {
  uint8_t b[BMI_FIFO_READ_FRAMES * BMI_FIFO_FRAME_BYTES];
  if (!bmiRead(BMI_FIFO_DATA, b, n * BMI_FIFO_FRAME_BYTES)) return false;
  for (uint16_t i = 0; i < n; i++) {
    const uint8_t* f = &b[i * BMI_FIFO_FRAME_BYTES];
    x[i] = (int16_t)((uint16_t)f[0] | ((uint16_t)f[1] << 8));
    y[i] = (int16_t)((uint16_t)f[2] | ((uint16_t)f[3] << 8));
    z[i] = (int16_t)((uint16_t)f[4] | ((uint16_t)f[5] << 8));
  }
  return true;
}

static bool bmiFifoFlush() {
  return bmiWrite(BMI_CMD, 0xB0);
}

// Before "off" (light sleep): the BMI270 is powered straight from 3V3 and would keep
// sampling at 800 Hz (~0.2 mA). Accelerometer off + advanced power save is
// a few uA. The next boot does a full bmiBegin() anyway.
static void bmiSleep() {
  bmiWrite(BMI_INT_MAP_DATA, 0x00);
  bmiWrite(BMI_PWR_CTRL, 0x00);
  bmiWrite(BMI_PWR_CONF, 0x03);
}
