lorenzogalli-dev/Prostart/(commit log)

2026-10-15 prostart app end to end, photofinish on the colleagues' detection, ESP32 BLE
    App (prostart/): BLE start unit (protocol mirror of the ESP32 Ble.h, clock
    sync from the per-direction ping/pong minima, PhoneClock on the camera's host
    clock), demo start unit, reaction screen mirroring the board, live photofinish
    (native 240 fps camera, frames in RAM from go, line band trigger) and analysis
    of recorded videos. flutter_blue_plus pinned to 1.36.8 (last BSD release).
    Tests for protocol and sync. App icon and splash logo from prostart-logo.
    Photofinish detection: local plugin packages/photofinish_camera, a Swift port
    of the colleagues' finisheye_detection (segmentation chest front, judge with
    the +/-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
2026-10-15 HANDOFF: final track-clip check, the chest dot, next session with the ESP32
2026-10-16 AlgorithmRealTimeESP32: BLE battery passed, IMU init recovery, sync-test LED; app mask overlay
    - ESP32 on the user's board: verify_rate 803.2 Hz, DROPPED 0, std 0.9 us
    (2.8 us with BLE connected); 3 starts in a row over BLE, every event,
    board == offline detector. Captures in Data/bench_161026/.
    - IMU init: on failure, I2C bus recovery + retry, then up to 3 restarts,
    then an IMU error screen and starts refused (was: UNUSABLE every start).
    - Green sync-test LED on GPIO21, lit at go with one register write.
    - verify_rate.py: bounded drain (hung forever on the continuous preview).
    - photofinish_camera: segmentation mask on the result frame for the live
    camera and every analysed video.
    -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
    [accel_20261016_111737_0.207s.csv, accel_20261016_111830_0.130s.csv, accel_20261016_111916_FS-0.899s.csv, accel_20261016_112133_0.133s.csv]
2026-10-16 AlgorithmRealTimeESP32 v6: fix FIFO-overwrite timestamp shift, no on-board storage, runs to the app over BLE
    Gym session 16/10: 10 of 18 starts read as false starts. The BMI270 FIFO
    holds 337 frames (0.42 s), not the 1024 assumed; the ~0.6-1 s stall after
    each start (flash write + serial dump) overwrote frames while their stamps
    stayed queued, shifting every later sample 0.4-1.05 s early. All 10 recover
    as valid starts (Data/gym_161026/corrected, correct_fifo_shift.py).
    Firmware:
    - overwrite detected (stamps vs frames) and resynced; capacity measured
    - flash storage removed; the run is held in RAM and sent over BLE
    (new data/ctrl characteristics, GET/ACK, re-sent holes)
    - serial never blo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
    [20261016_113249_r00024_0.426s.csv, nodate_r00025_0.238s.csv, nodate_r00026_0.155s.csv, nodate_r00030_0.551s.csv, nodate_r00030_0.551s_corrected.csv, nodate_r00031_FS-0.316s.csv, nodate_r00031_FS-0.316s_corrected.csv, nodate_r00032_FS-0.334s.csv]
2026-10-18 Final paper draft (3 pages + appendix), PCB and enclosure in Hardware/, docs in Docs/
    - Papers/Final Paper: main.tex on the ELR style without logo and rule, page-1
    header space reclaimed; figures/ with make_figures.py (enclosure render from
    the STL files, error-scale plot, ESP32 start) and placeholders still to fill
    - Hardware/PCB_ProStart_POC (KiCad project, Gerbers, BOM) and
    Hardware/Enclosure (start_box, start_box_lid, start_box_button STL)
    - Docs/: HANDOFF, RUN, BUILD, ALGORITHM (was INFO.md), figures/,
    hardware_photos/, references/; Papers/Half-Time Paper
    - Photofinish_Python -> AI_Torso_Detector; old start_detector archived in
    Arduino/AlgorithmRealTime/Python_Tools/archive/
    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
    [PCB_ProStart_POC.dsn, PCB_ProStart_POC.kicad_pcb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]
2026-10-18 Paper aligned with firmware v6, repo renamed to Prostart
    - main.tex: runs saved by the app over BLE (no flash storage), FIFO 337
    frames, jitter 0.9 us (2.8 us with the phone connected), LED D1 on GPIO21,
    BLE data/ctrl characteristics; repository URL -> lorenzogalli-dev/Prostart
    - correct_fifo_shift.py: import path relative to the script, not to the folder name
    - README tree and HANDOFF updated for the rename
    [correct_fifo_shift.py]
2026-10-19 Rewrite README, add MIT license, tidy the public repo
    - README rewritten from the final paper: system, results, parts cost, business plan
    - Add LICENSE (MIT) and the unit + app photo
    - Stop tracking HANDOFF.md, reference PDFs, presentation media, editor and KiCad local state
    - Rename the block-start figure; note that RUN/BUILD cover the XIAO prototype
    [temp-freerouting.dsn]
2026-10-19 README: unit runs from a power bank for now, LiPo planned
2026-10-20 Final presentation: updated frame-rate wording and slide order, copy in Papers/Final Paper
